mojtaba-brz/AerialInspection-IndustrialStacks/UAV-Design-Article/Pictures/city-industrial-silhouette-9138f2.webp

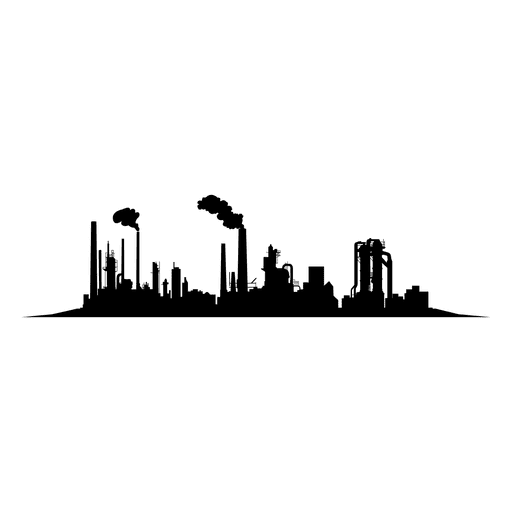
UAV-Design-Article/Pictures/city-industrial-silhouette-9138f2.webp
