mojtaba-brz/AerialInspection-IndustrialStacks/UAV-Design-Article/Pictures/envea-emissions-monitoring-compliance-solution-4-1.jpg

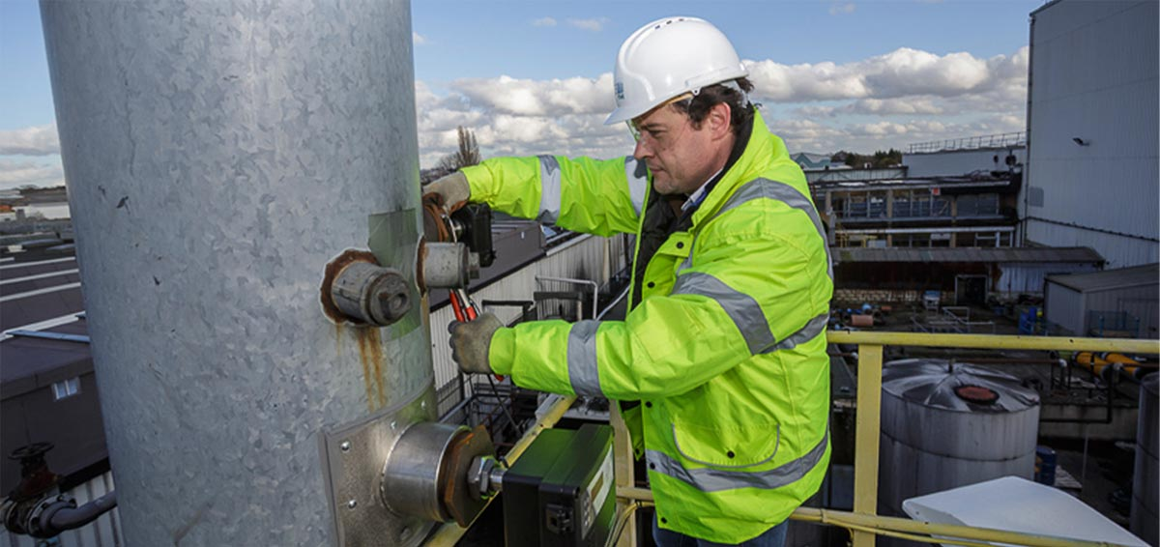
UAV-Design-Article/Pictures/envea-emissions-monitoring-compliance-solution-4-1.jpg
