mojtaba-brz/AerialInspection-IndustrialStacks/UAV-Design-Article/Pictures/heavy-industry-petrochemical-chemical-plant-industrial-worker-5024c2596659f4908fa87ac0a7236dae.png

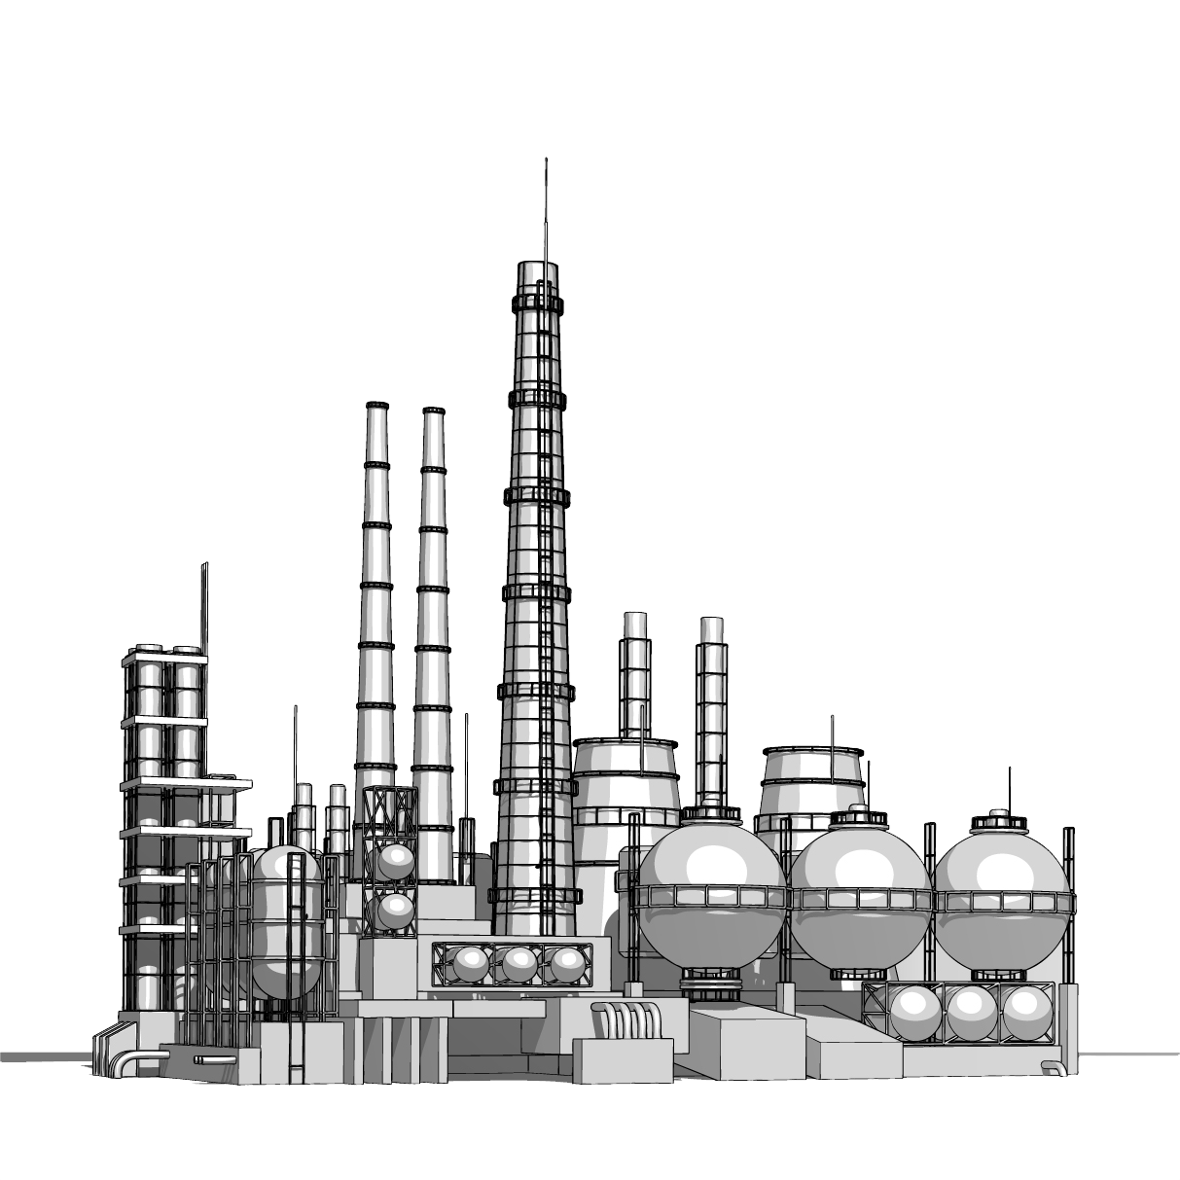
UAV-Design-Article/Pictures/heavy-industry-petrochemical-chemical-plant-industrial-worker-5024c2596659f4908fa87ac0a7236dae.png
