mojtaba-brz/AerialInspection-IndustrialStacks/UAV-Design-Article/Pictures/Inspection.jpg

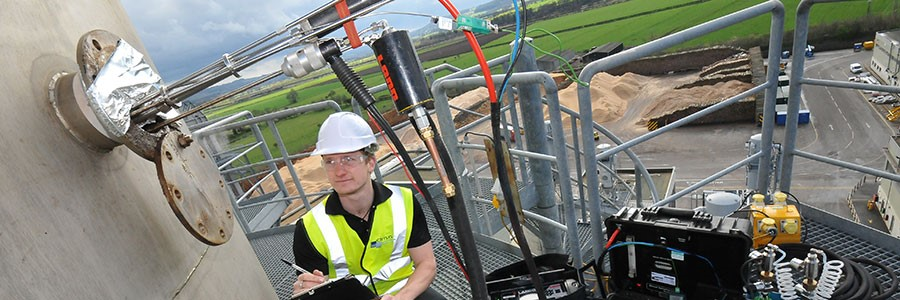
UAV-Design-Article/Pictures/Inspection.jpg
