mojtaba-brz/AerialInspection-IndustrialStacks/UAV-Design-Article/Pictures/jhe3one3ng8lbj9tsldhh4opan.png

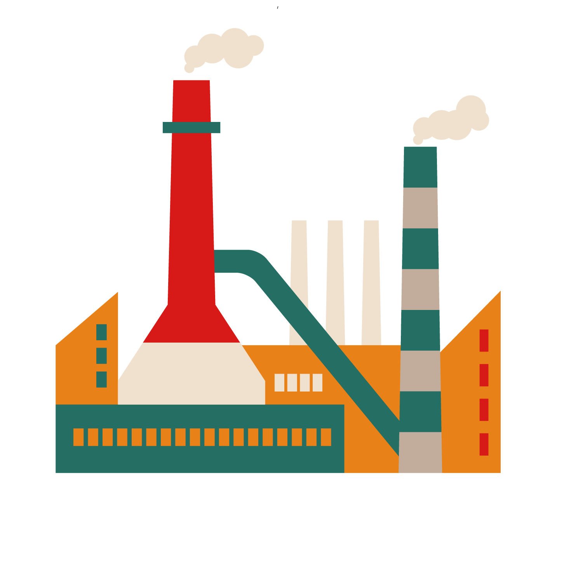
UAV-Design-Article/Pictures/jhe3one3ng8lbj9tsldhh4opan.png
