mojtaba-brz/AerialInspection-IndustrialStacks/UAV-Design-Article/Pictures/oil-refinery-power-station-petroleum-illustration-coal-power-stations-c98e379eabff41b512c797f35c45e14e.png

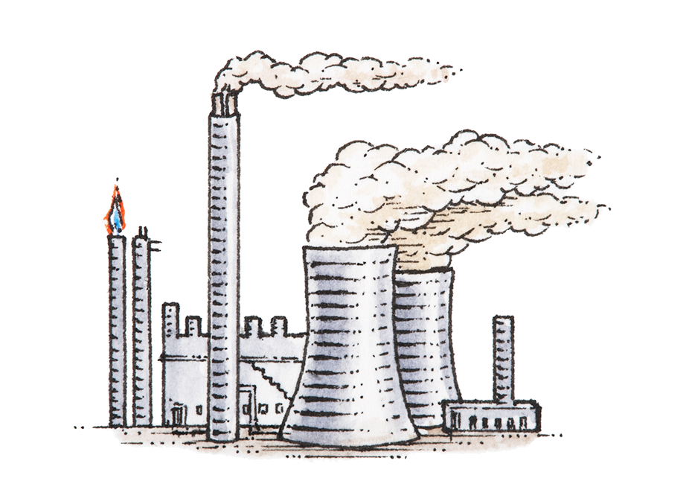
UAV-Design-Article/Pictures/oil-refinery-power-station-petroleum-illustration-coal-power-stations-c98e379eabff41b512c797f35c45e14e.png
