mojtaba-brz/AerialInspection-IndustrialStacks/UAV-Design-Article/Pictures/pngwing.com.png

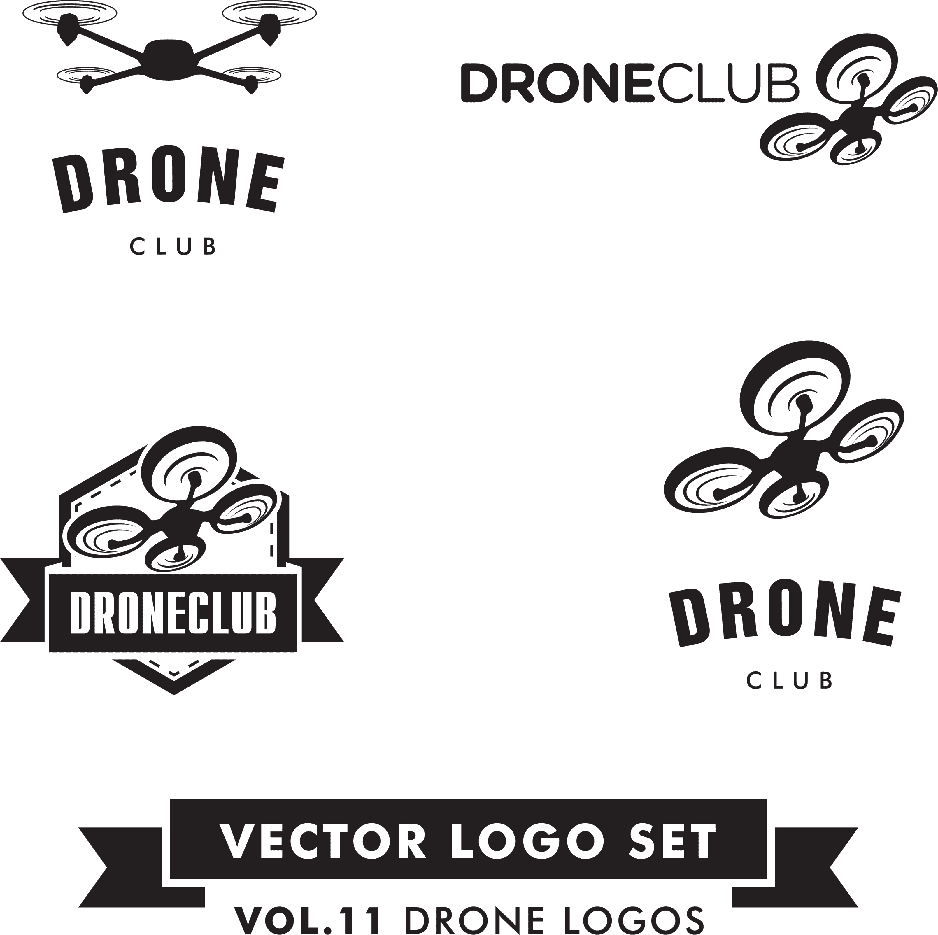
UAV-Design-Article/Pictures/pngwing.com.png
