mojtaba-brz/AerialInspection-IndustrialStacks/UAV-Design-Article/Pictures/StandardFlangeAndCover.JPG

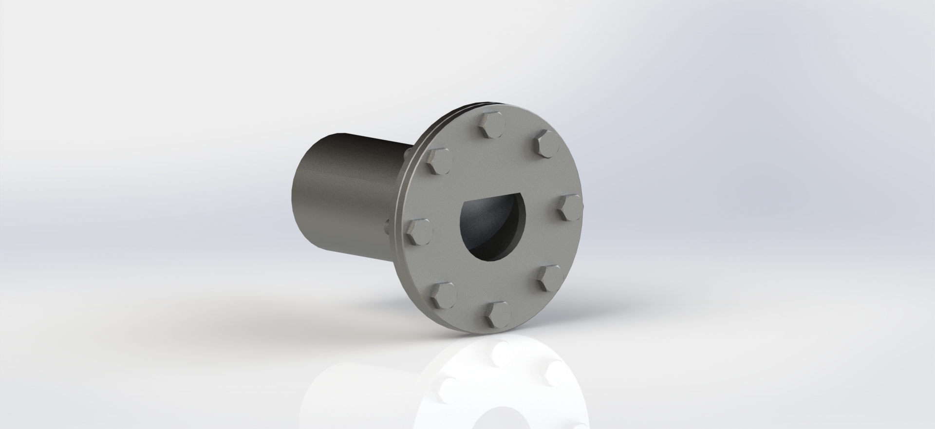
UAV-Design-Article/Pictures/StandardFlangeAndCover.JPG
