mojtaba-brz/AerialInspection-IndustrialStacks/UAV-Design-Article/Pictures/StandardFlangeAndCoverMidSection.JPG

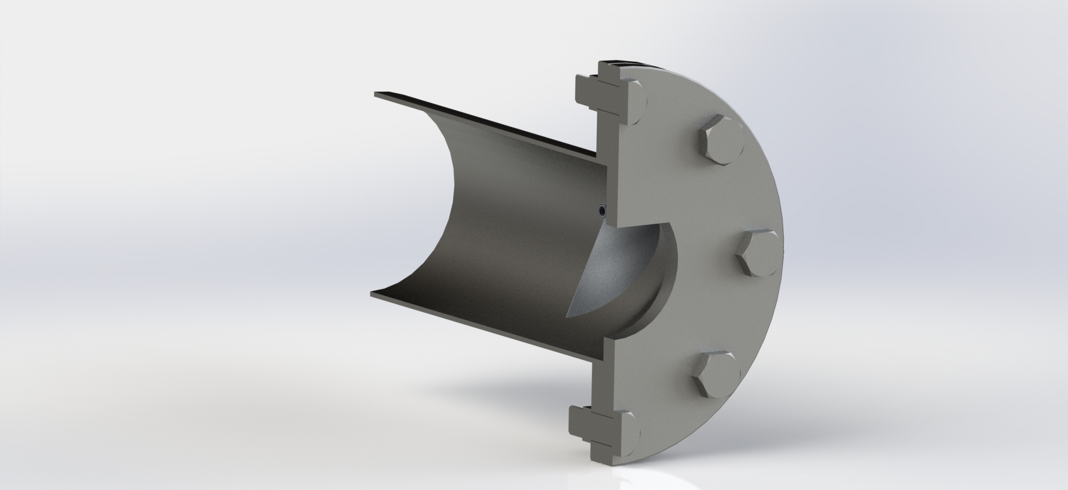
UAV-Design-Article/Pictures/StandardFlangeAndCoverMidSection.JPG
