mojtaba-brz/AerialInspection-IndustrialStacks/UAV-Design-Article/CAD Models/TypicalFlangeAndCover.SLDASM

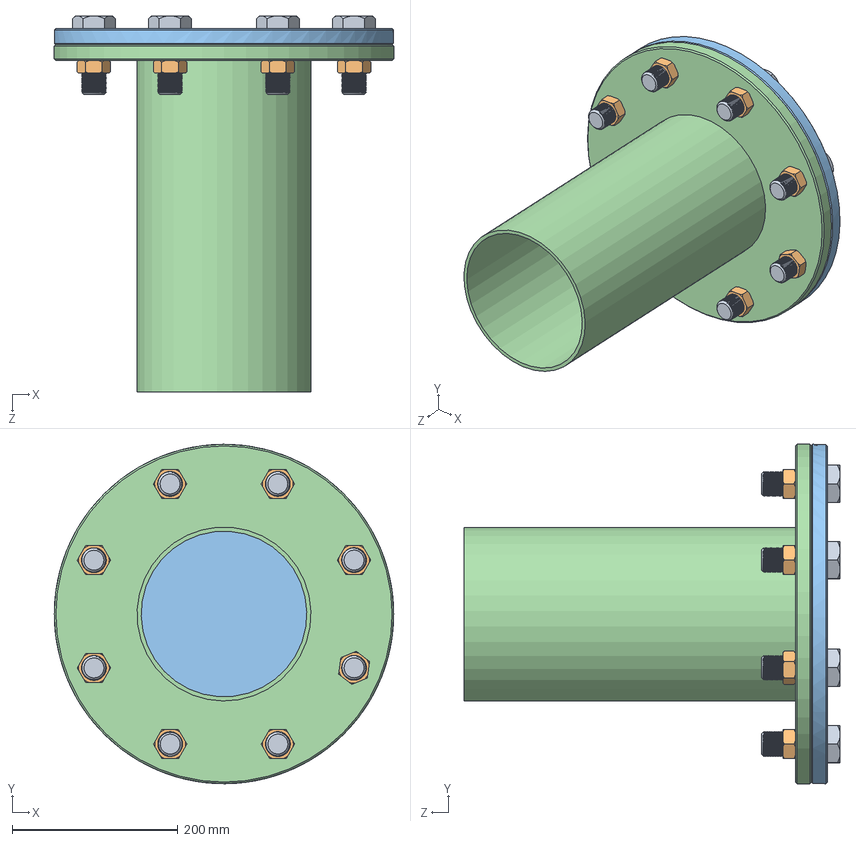
[picture p53: CAD file, 2025-03-14]
UAV-Design-Article/CAD Models/TypicalFlangeAndCover.SLDASM
410.0 x 410.0 x 454.0 mm
Bolt x 8
Nut x 8
TypicalCover
TypicalFlange
