mojtaba-brz/AerialInspection-IndustrialStacks/UAV-Design-Article/CAD Models/StandardizedFlangeAndCover.SLDASM

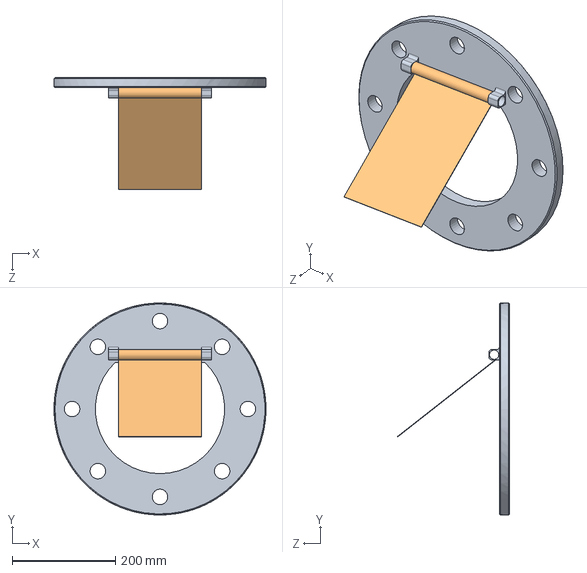
[picture p54: CAD file, 2025-03-14]
UAV-Design-Article/CAD Models/StandardizedFlangeAndCover.SLDASM
410.0 x 409.8 x 217.2 mm
StandardizedCover
StandardizedDoor
