mojtaba-brz/AerialInspection-IndustrialStacks/UAV-Design-Article/CAD Models/TypicalCover.SLDPRT

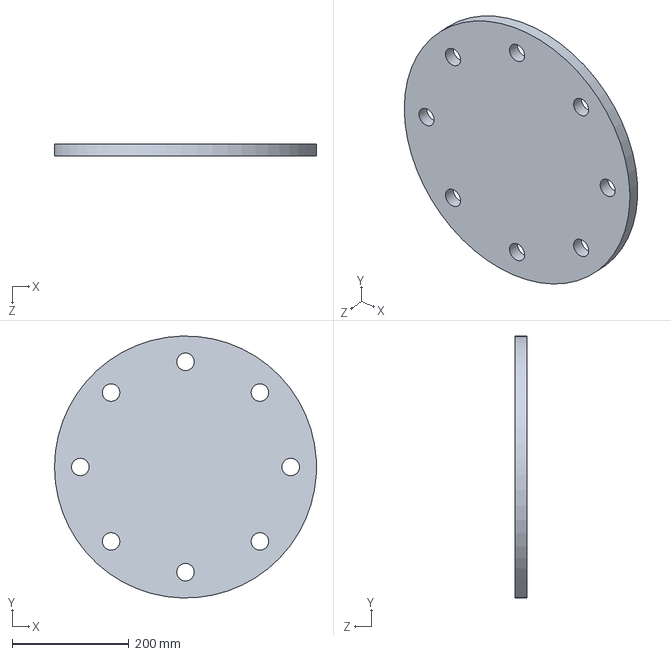
[picture p55: CAD file, 2025-03-14]
UAV-Design-Article/CAD Models/TypicalCover.SLDPRT
448.2 x 448.0 x 20.0 mm
