mojtaba-brz/AerialInspection-IndustrialStacks/UAV-Design-Article/CAD Models/StandardizedCover.SLDPRT

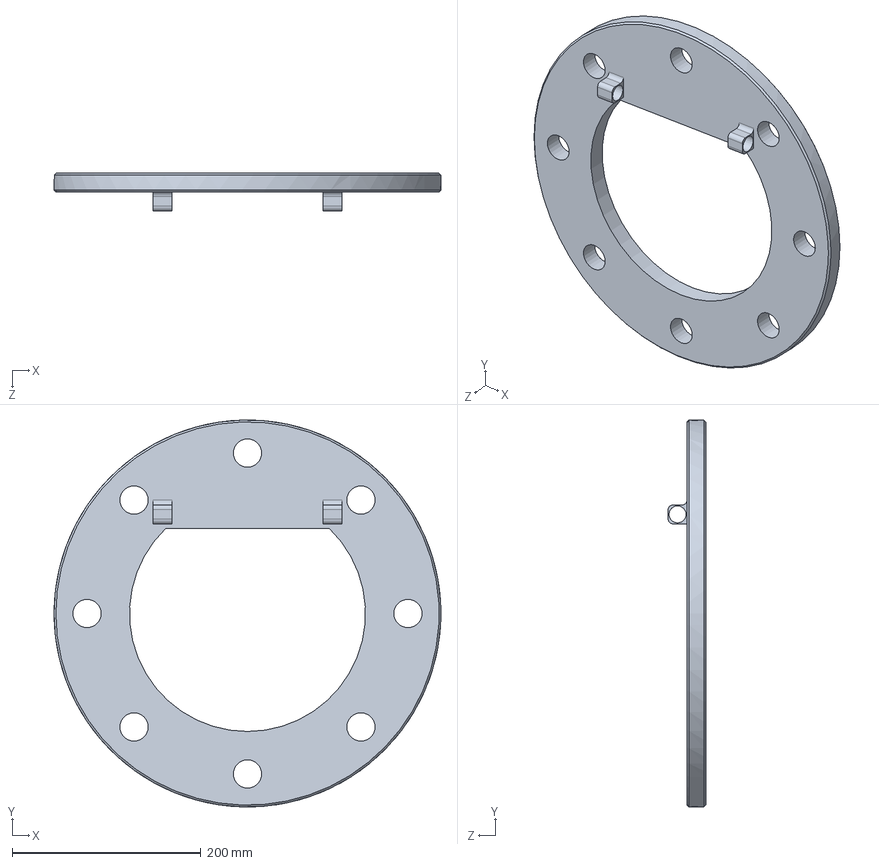
[picture p56: CAD file, 2025-03-14]
UAV-Design-Article/CAD Models/StandardizedCover.SLDPRT
410.0 x 409.8 x 40.0 mm
