mojtaba-brz/AerialInspection-IndustrialStacks/UAV-Design-Article/CAD Models/StandardFlangeShaft.SLDPRT

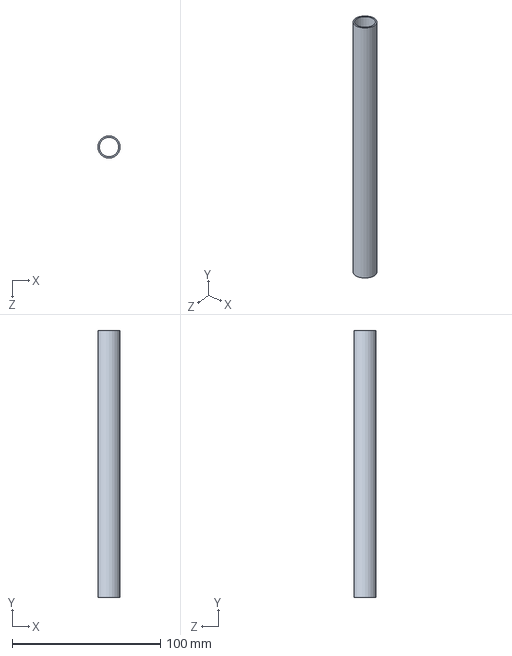
[picture p57: CAD file, 2025-03-14]
UAV-Design-Article/CAD Models/StandardFlangeShaft.SLDPRT
15.0 x 180.0 x 15.0 mm
