mojtaba-brz/AerialInspection-IndustrialStacks/UAV-Design-Article/CAD Models/TypicalFlange.SLDPRT

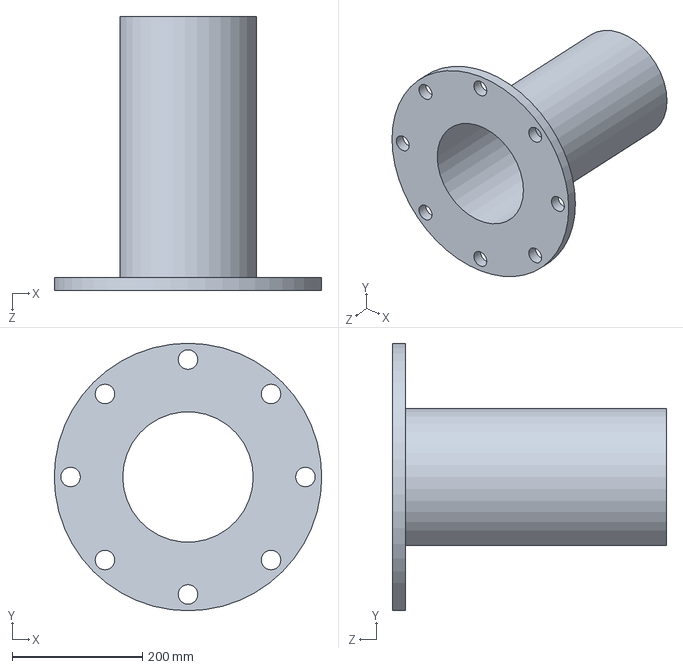
[picture p58: CAD file, 2025-03-14]
UAV-Design-Article/CAD Models/TypicalFlange.SLDPRT
410.0 x 410.0 x 420.0 mm
