mojtaba-brz/AerialInspection-IndustrialStacks/UAV-Design-Article/CAD Models/StandardizedDoor.SLDPRT

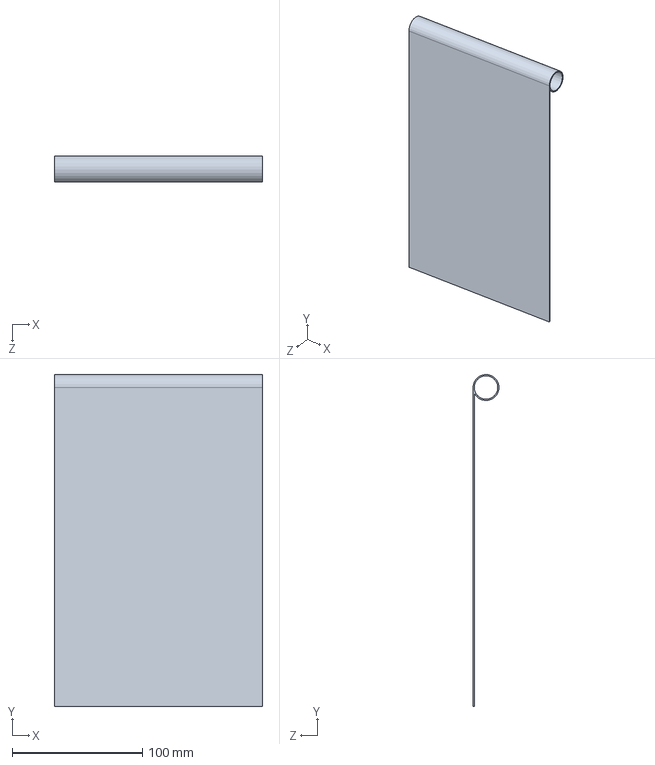
[picture p59: CAD file, 2025-03-14]
UAV-Design-Article/CAD Models/StandardizedDoor.SLDPRT
160.0 x 255.0 x 20.0 mm
