mojtaba-brz/AerialInspection-IndustrialStacks/UAV-Design-Article/CAD Models/Nut.SLDPRT

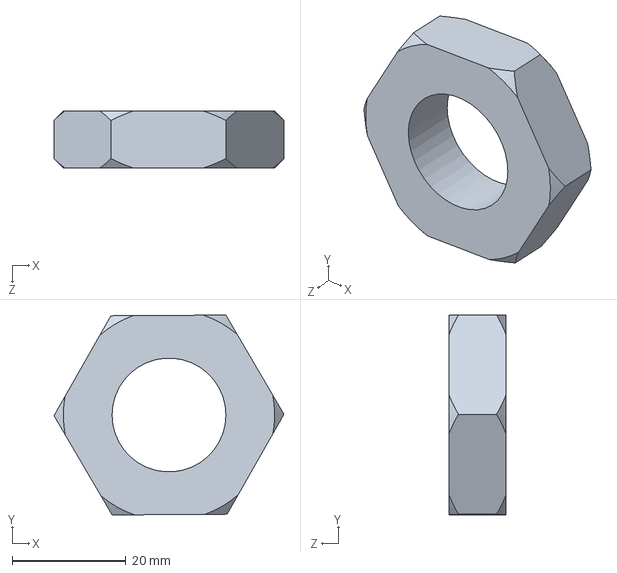
[picture p60: CAD file, 2025-03-14]
UAV-Design-Article/CAD Models/Nut.SLDPRT
40.4 x 35.1 x 10.0 mm
