mojtaba-brz/AerialInspection-IndustrialStacks/UAV-Design-Article/CAD Models/Bolt.SLDPRT

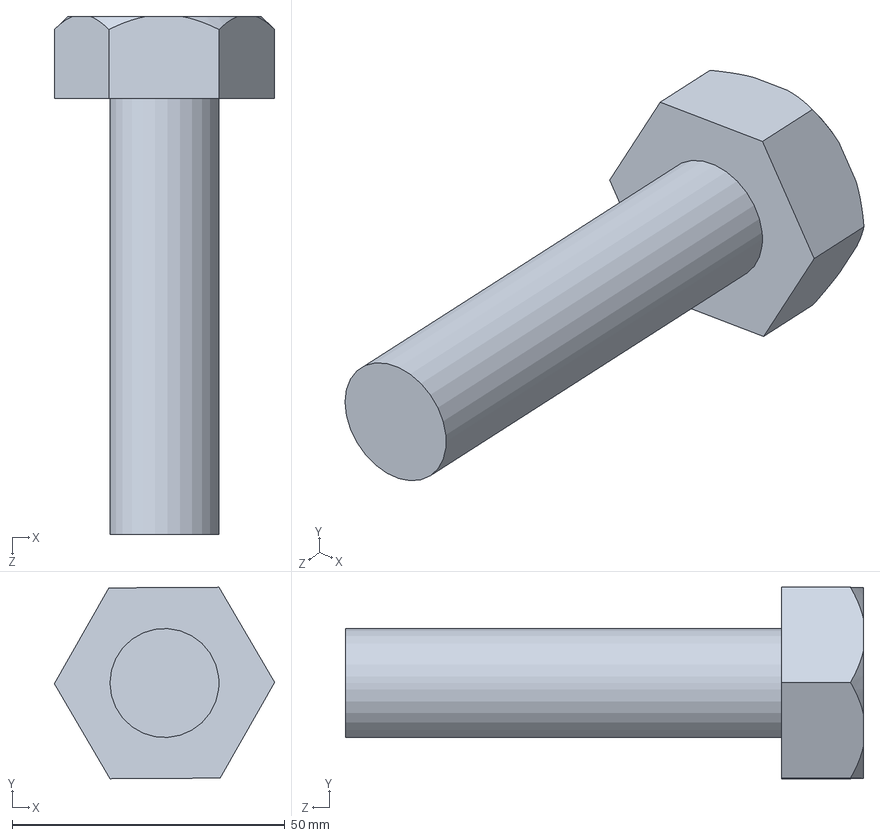
[picture p61: CAD file, 2025-03-14]
UAV-Design-Article/CAD Models/Bolt.SLDPRT
40.4 x 35.1 x 95.0 mm
